Shamshel/Phone_Finder/Documentation/Requirements and Specifications/Customer Requirements/Customer Requirements.pdf

May 26, 2015• Rev A

# Customer Requirements

Cody Herndon

codyray.herndon@gmail.com

Abstract

This document outlines the customer requirements for a device intended to ease locating a nearby cell phone. The device is intended to be worn as a necklace, on a bracelet, or on a key chain as a key fob. When activated, the device will wirelessly signal the connected cell phone to sound an alarm to aid in its location.

I. Introduction

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

II. Scope

This document pertains only to customer requirements. Such requirements are often vague and guide designers to key features that are important to an implementation. For more specific requirements, please refer to the Engineering Requirements document.
This document pertains only to the device outlined above and not to a remote device. The device should be used with a modern “smart” cell phone, which often feature numerous wireless interfaces. Selection of a wireless standard and determination of the fitness of a particular device is beyond the scope of this document. For more information about the specific selection of wireless interface, and supported phones and devices refer to the Feasibility Analysis document.

III. Functional

This section outlines features and specifications that are required for normal use-case operation.

1

1. Mechanical
(a) The device shall feature an attachment point for a chain or key ring.
(b) The device shall feature a button to activate the associated application.
(c) The device shall feature an internal antenna.
2. Electrical
(a) Battery and Endurance
i. The device shall have a battery life of approximately one year. ii. The device shall feature a means of replenishing the battery power.
(b) Wireless Connectivity
i. The device shall connect to a remote device wirelessly.
ii. The device shall implement a wireless communication system that is standard on modern (later than 2010) smart phone devices.
iii. The device shall connect to the remote device over a distance approximately the length of a suburban living room.
iv. The device shall be capable of transmitting data wirelessly through obstacles such as walls or furniture.
(c) Computational
i. Uniqueness
A. When the device (α) is connected to a remote device (α

0
), and an identical device (β) is connected to another remote device (β

0
), the activation of the device (α) shall only activate the connected remote device (α

0
).
B. A device shall only be capable of being connected to a single remote device at any given time.
ii. Companion Application
A. The companion application shall be capable of receiving and interpreting transmissions from the device.
B. The companion application shall be capable of sounding an alarm or message tone from the remote device in response to an activation message from the device.

IV. Non-Functional

This section outlines features and specifications that relate to the expected operating environment and device durability.

1. Mechanical
(a) The device shall be comfortably worn as a necklace or be attached to a key chain.
(b) The device shall be rounded and smooth so as not to injure the operator when worn close to or on the skin.
(c) The device shall be rounded and smooth so as not to catch, snag, scratch, or tear the operator’s garments.
(d) The device shall be capable of operating correctly after multiple drops from the approximate height of the top of an operator’s head.

2

2. Environmental
(a) The device shall be capable of operating correctly under heavy clothing or close to or on the skin of an operator.
(b) The device shall be capable of operating correctly under high humidity conditions.
(c) The device shall feature a rigid housing that resists penetration.
(d) The device shall be water resistant or waterproof.
(e) The device shall feature dust and particle ingress protection.
(f) The device shall feature a rigid housing that does not become pliable due to heat, pressure, or humidity when worn under heavy clothing or close to or on the skin of the operator.
(g) The device shall feature a rigid housing that does not irritate the skin when in continuous contact.
V. Revision History

2015-05-26 Initial production

3
