Shamshel/Phone_Finder/Documentation/Circuit/Phone Finder 3D.PNG

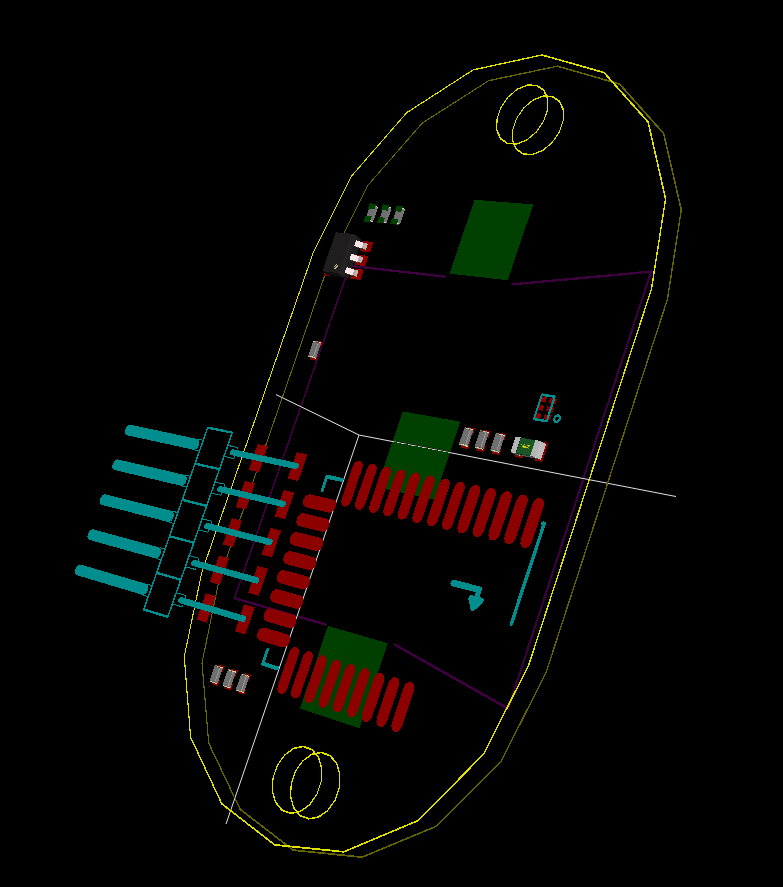
Documentation/Circuit/Phone Finder 3D.PNG
