Shamshel/Phone_Finder/Documentation/Circuit/Phone Finder Schematic.PNG

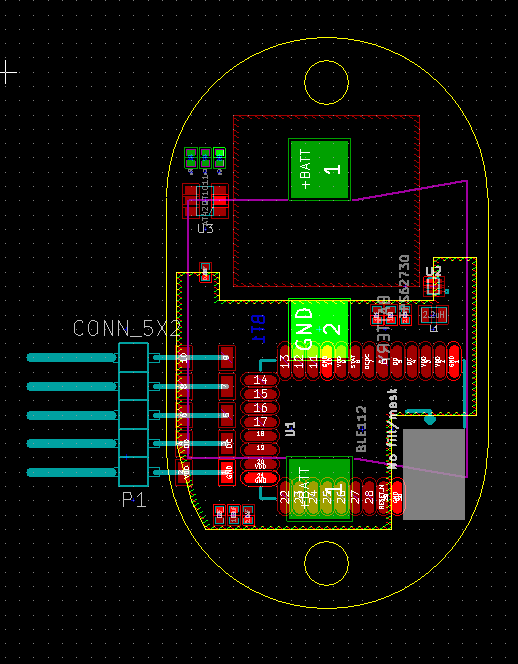
Documentation/Circuit/Phone Finder Schematic.PNG
