Shamshel/Phone_Finder/Documentation/Circuit/Phone_Finder.csv

ref | value | footprint | quantity ordered
BT1 | BATTERY | BHX1-2032-SM | 3
C1 | 1uF | SM0603_Capa | 10
C2 | 1uF | SM0603_Capa | 10
C3 | 100uF | SM1206 | 5
C4 | 2.2uF | SM0603_Capa | 10
C5 | 2.2uF | SM0603_Capa | 10
C9 | 1uF | SM0603_Capa | 10
D1 | LED | LED-0805 | 5
L1 | 2.2uH | SM0603 | 10
P1 | CONN_5X2 | pinhead-1-2X05SMD/90 | 3
Q1 | NPN | SOT23 | 10
R1 | R | SM0603 | 50
R2 | 10k | SM0603 | 50
SW1 | SPST | KSC_GULLWING | 6
U1 | BLE112 | BLE112-A | 4
U2 | TPS62730 | SON6 | 4
