Shamshel/Phone_Finder/Documentation/Circuit/Phone_Finder.kicad_pcb

## KiCad design Documentation/Circuit/Phone_Finder.kicad_pcb (2015-06-09)

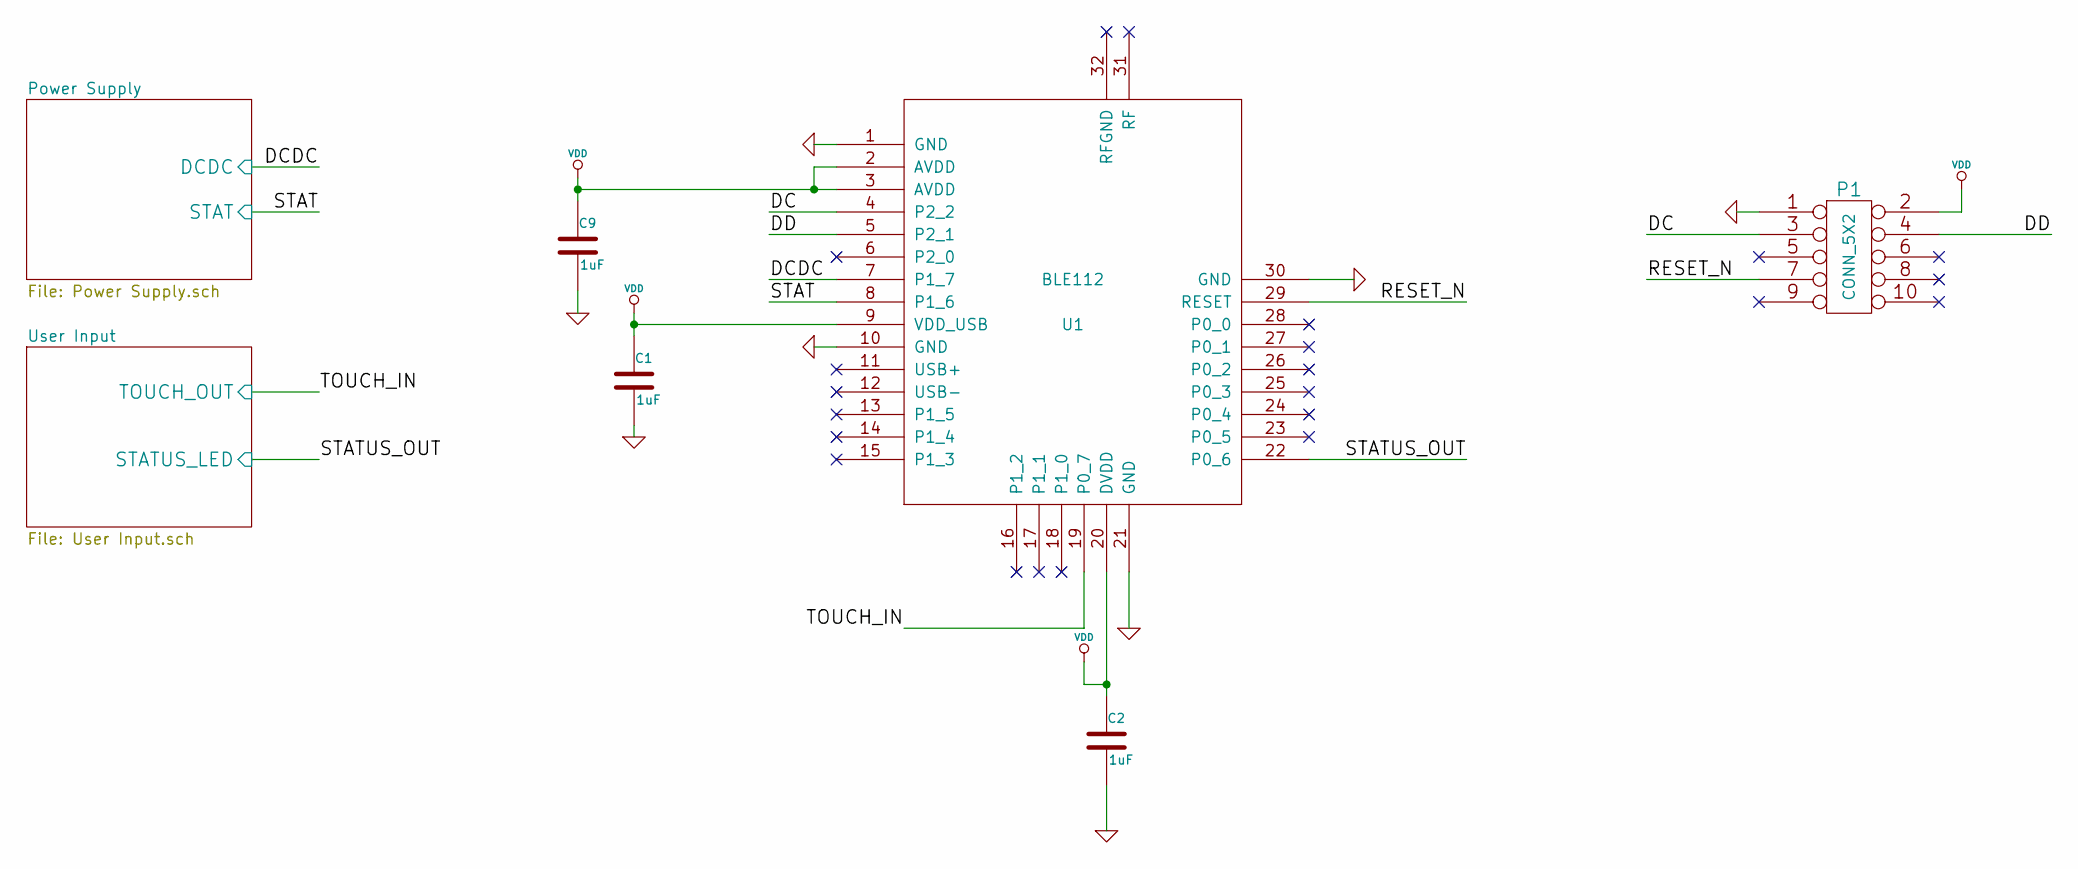
[picture p3: schematic Phone_Finder.sch]

Parts:
C1, C2, C9: 1uF
P1: CONN_5X2
U1: BLE112; MODULE

Connections:
/DC: P1.3, U1.4 (P2_2)
/DD: P1.4, U1.5 (P2_1)
/Power Supply/DCDC: U1.7 (P1_7); also elsewhere on the board
/Power Supply/STAT: U1.8 (P1_6); also elsewhere on the board
/RESET_N: P1.7, U1.29 (RESET)
/User Input/STATUS_LED: U1.22 (P0_6); also elsewhere on the board
/User Input/TOUCH_OUT: U1.19 (P0_7); also elsewhere on the board
GND: C1.2, C2.2, C9.2, P1.1, U1.1 (GND), U1.10 (GND), U1.21 (GND), U1.30 (GND); also elsewhere on the board
VDD: C1.1, C2.1, C9.1, P1.2, U1.2 (AVDD), U1.3 (AVDD), U1.9 (VDD_USB), U1.20 (DVDD); also elsewhere on the board

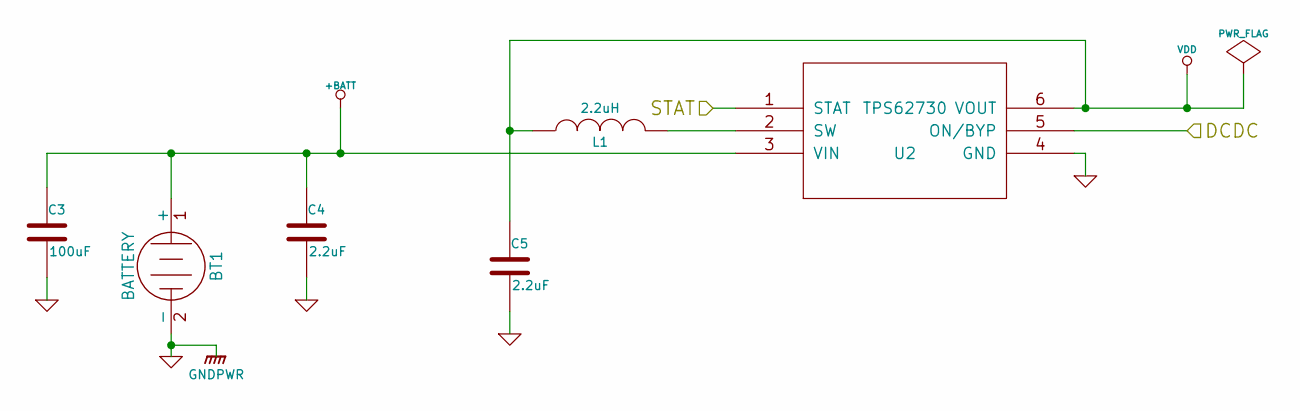
[picture p4: schematic Power Supply.sch]

Parts:
BT1: BATTERY
C3: 100uF
C4, C5: 2.2uF
L1: 2.2uH
U2: TPS62730; MODULE

Connections:
+BATT: BT1.1 (+), C3.1, C4.1, U2.3 (VIN)
/Power Supply/DCDC: U2.5 (ON/BYP); also elsewhere on the board
/Power Supply/STAT: U2.1 (STAT); also elsewhere on the board
GND: BT1.2 (-), C3.2, C4.2, C5.2, U2.4 (GND); also elsewhere on the board
unnamed: L1.2, U2.2 (SW)
VDD: C5.1, L1.1, U2.6 (VOUT); also elsewhere on the board

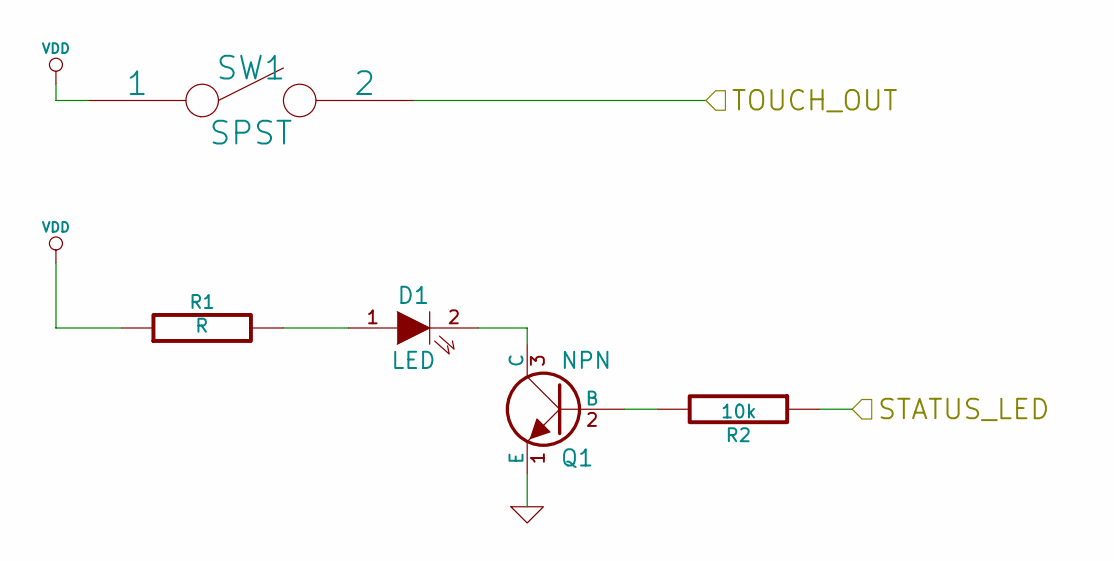
[picture p5: schematic User Input.sch]

Parts:
D1: LED
Q1: NPN
R1: R
R2: 10k
SW1: SPST

Connections:
/User Input/STATUS_LED: R2.1; also elsewhere on the board
/User Input/TOUCH_OUT: SW1.2; also elsewhere on the board
GND: Q1.1 (E); also elsewhere on the board
unnamed: D1.1 (A), R1.2
unnamed: D1.2 (K), Q1.3 (C)
unnamed: Q1.2 (B), R2.2
VDD: R1.1, SW1.1; also elsewhere on the board

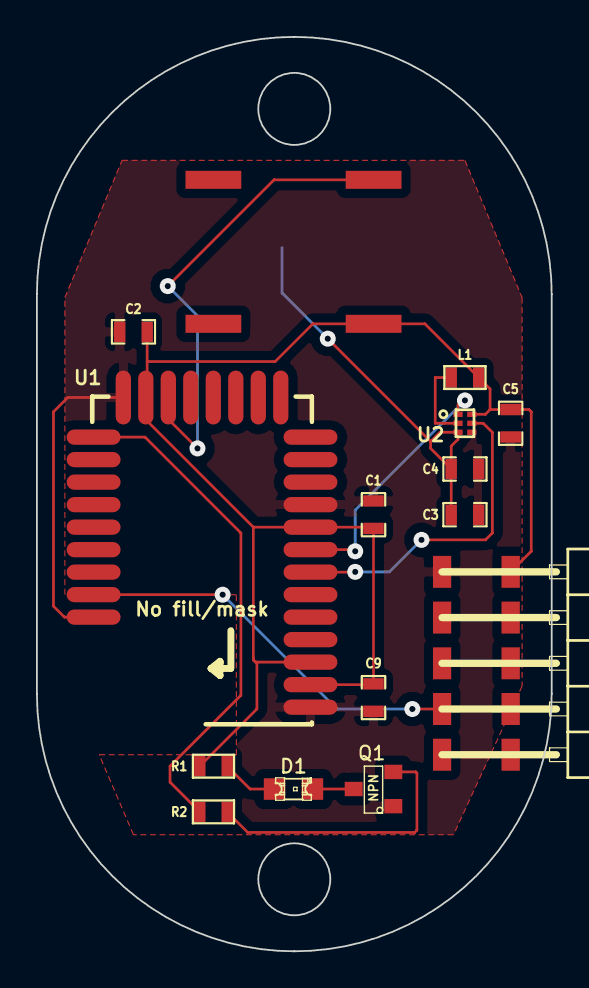
[picture p6: board Phone_Finder.kicad_pcb from above]

Board: 2 copper layers, 28.6 x 50.8 mm, 16 parts (1 on the bottom side), 14 nets.
