Shamshel/Phone_Finder/(commit log)

2015-05-28 Chipset and Power Investigation
    Investigated and took notes for various chipsets for a BLE/Bluetooth
    Smart implementation.
2015-06-01 Added datasheets
    Found coin cell battery holder with retaining clip for shock and
    vibration absorption. Added datasheet for BLE112, the BLE113 is a class
    3 device and is underpowered for the application specifications.
2015-06-02 Added schematic, BLE112 Datasheet
    Began work on the system schematic. System schematic currently assumes
    primary (non-rechargeable) coin-cell battery operating at a nominal 3V.
    Step-down buck converter circuit follows recommended schematic from the
    BLE112 datasheet (pg 19).
    [Phone_Finder.sch, Power Supply.sch, User Input.sch]
2015-06-04 Worked on schematic and PCB
    Worked on circuit schematic. Circuits utilized should reflect those in
    the BLE112 and AT42 datasheets. Added initial PCB layout. Routing
    still needs to be done for PCB layout. Circuit layout should be double
    checked before routing. Refer to an-kd02_103 for more details on touch
    interface layout. Refer to tps62732 datasheet for more details on power
    system layout.
    [Phone_Finder.kicad_pcb, Phone_Finder.sch, Power Supply.sch, User Input.sch]
2015-06-09 Modified input circuitry, remade PCB
    Changed input circuit from Atmel's QTouch chipset to a simple momentary
    pushbutton, added datasheet for said pushbutton. Button is dust tight
    and waterproof as per spec doc.
    Changed passives to use 0603 footprint instead of 0402 to provide easier
    reflowing.
    Performed initial layout, connectivity, and ground pours.
    Still pending are circuit connectivity and feasibility, and PCB
    connectivity checks. Parts might be purchased at this point. Parts
    will then be compared against footprints to ensure fit before sending
    gerbers (and order) off to PCB fab.
    [Phone_Finder.kicad_pcb, Phone_Finder.sch, Power Supply.sch, User Input.sch]
2015-06-11 Added BoM, OSHpark estimate
    Added BoM, added estimated cost for board fabrication from OSHpark.
    [Phone_Finder.csv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]
